aspdigital/AES50/Hardware Design/Schematic.pdf

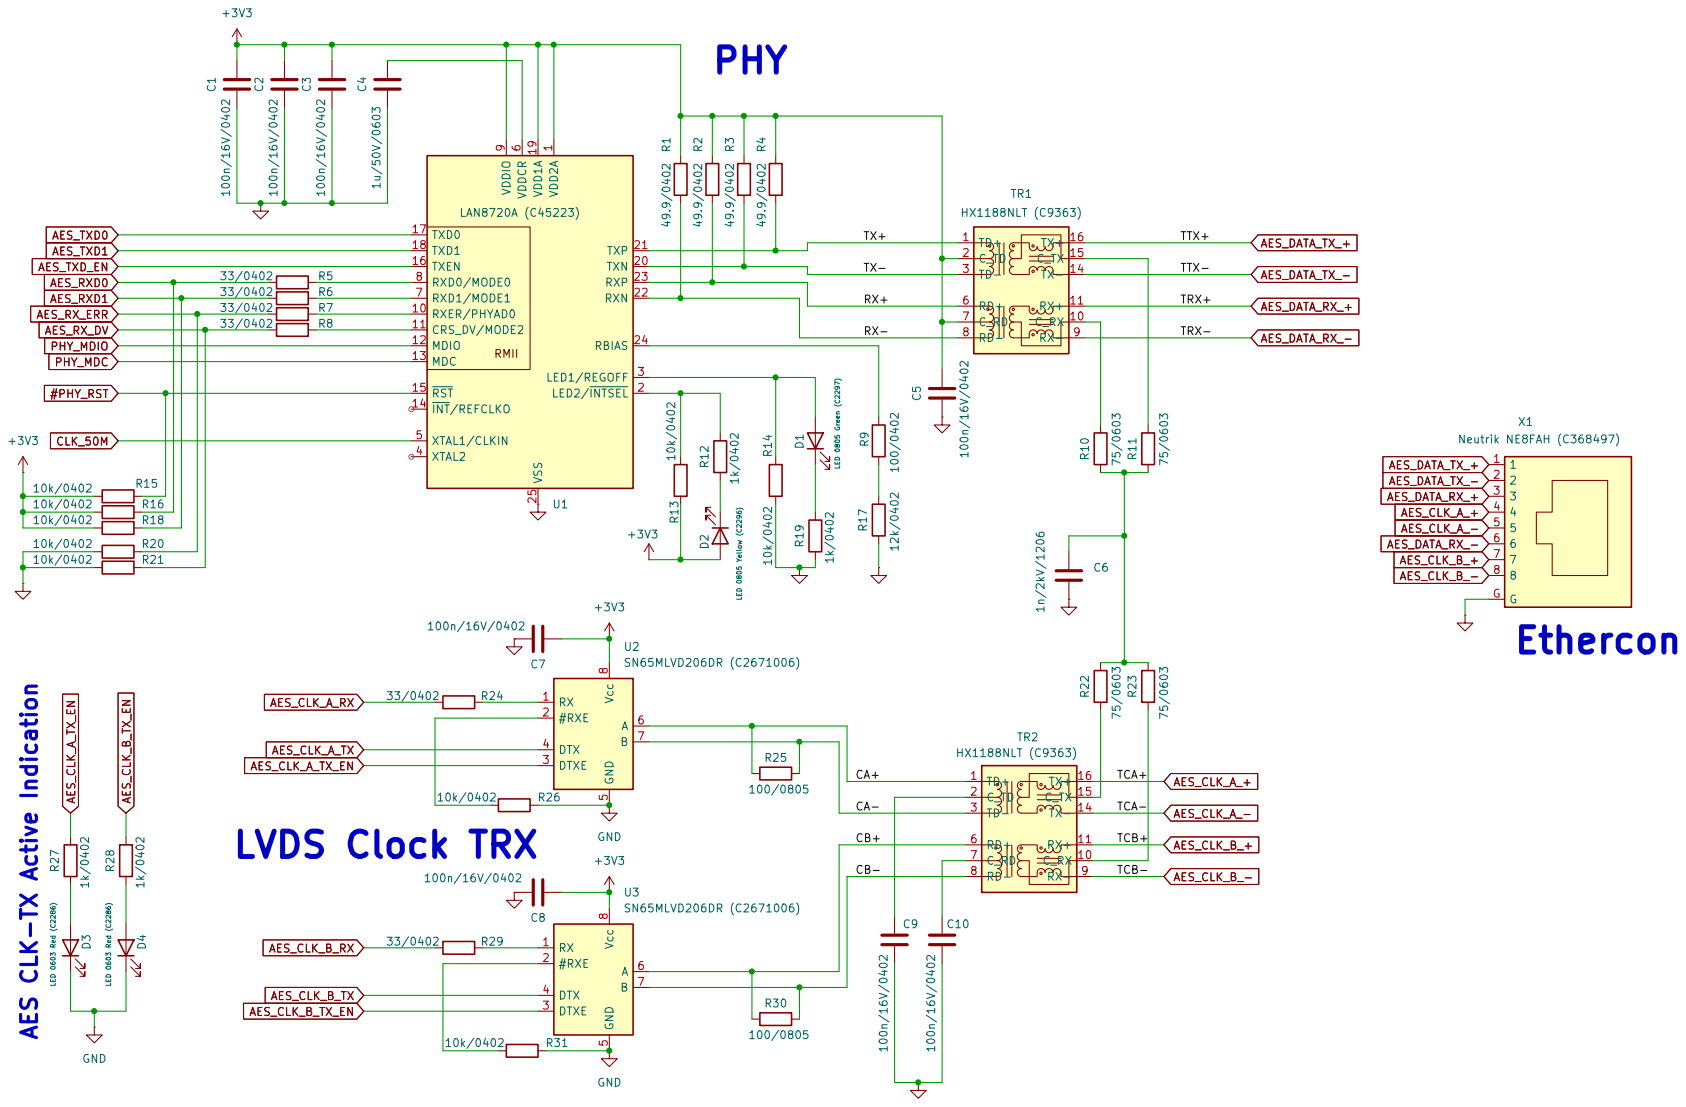
[picture p6: page 2]

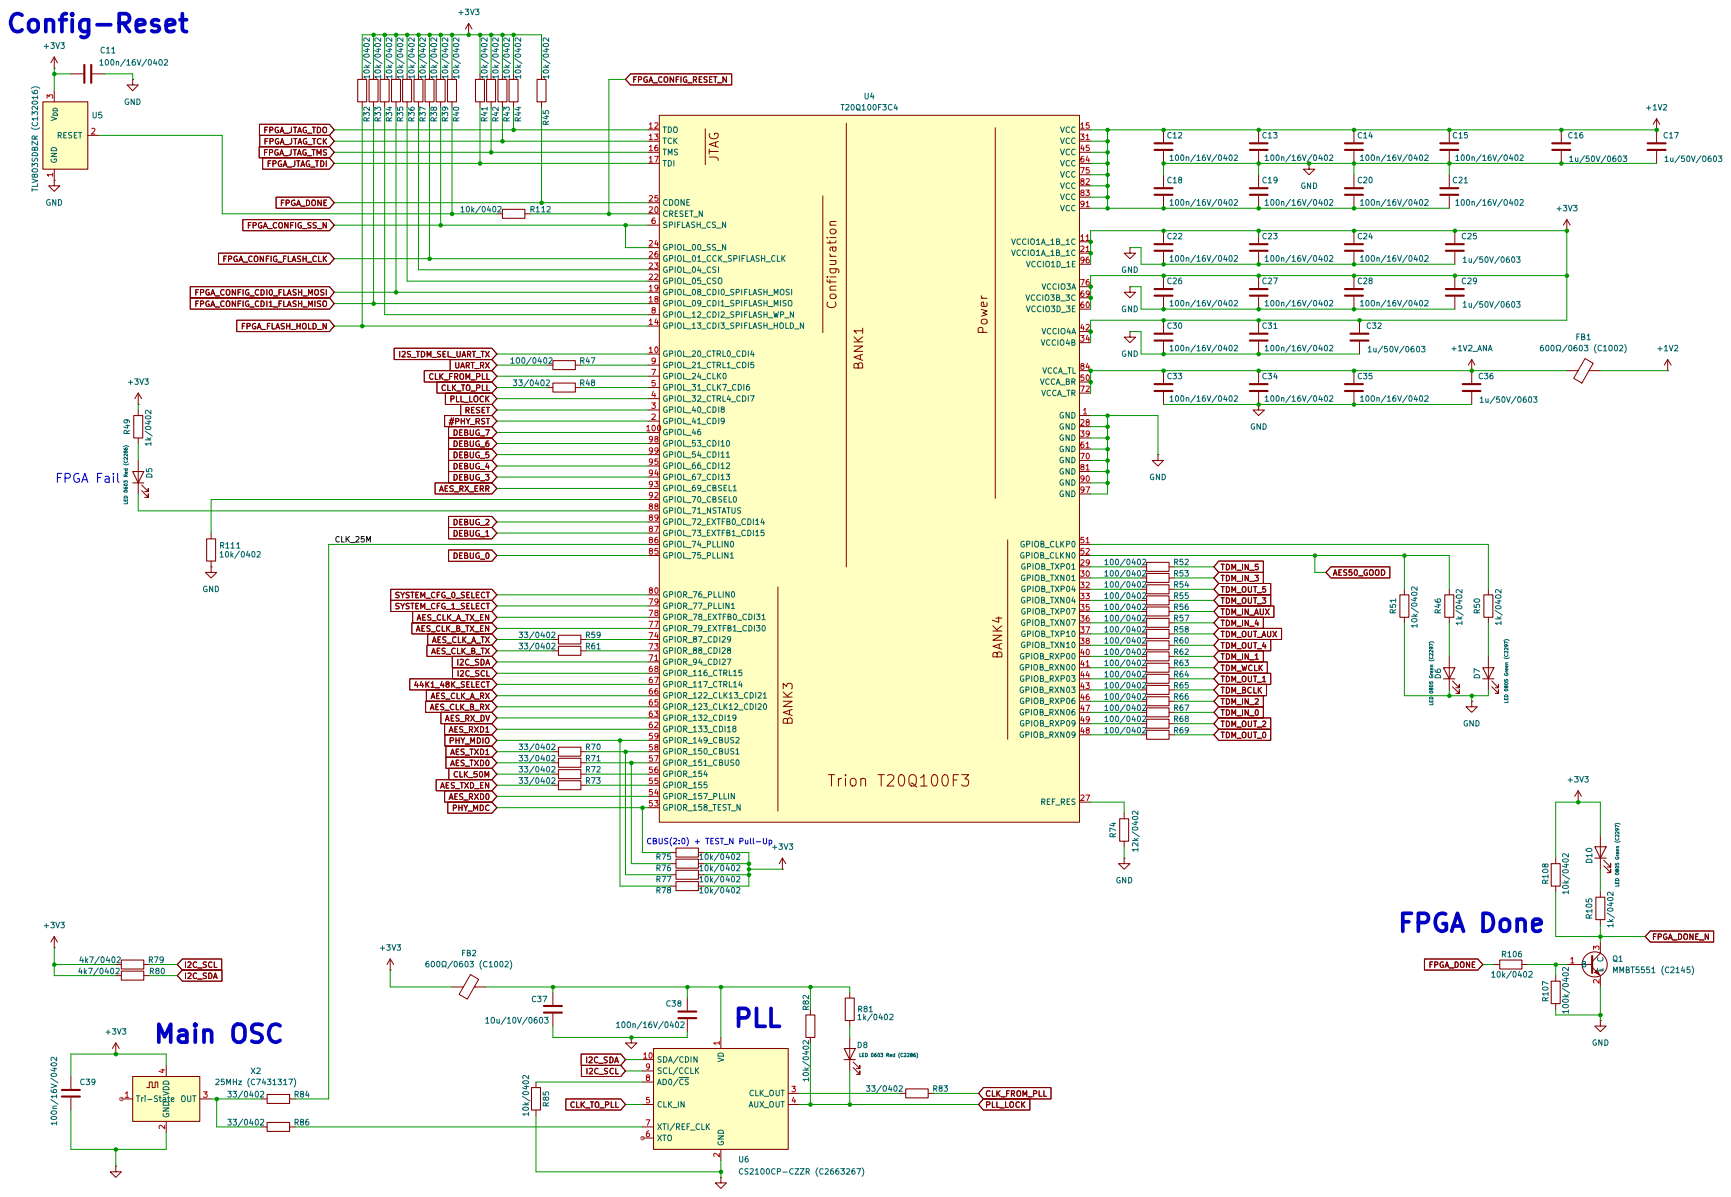
[picture p7: page 3]

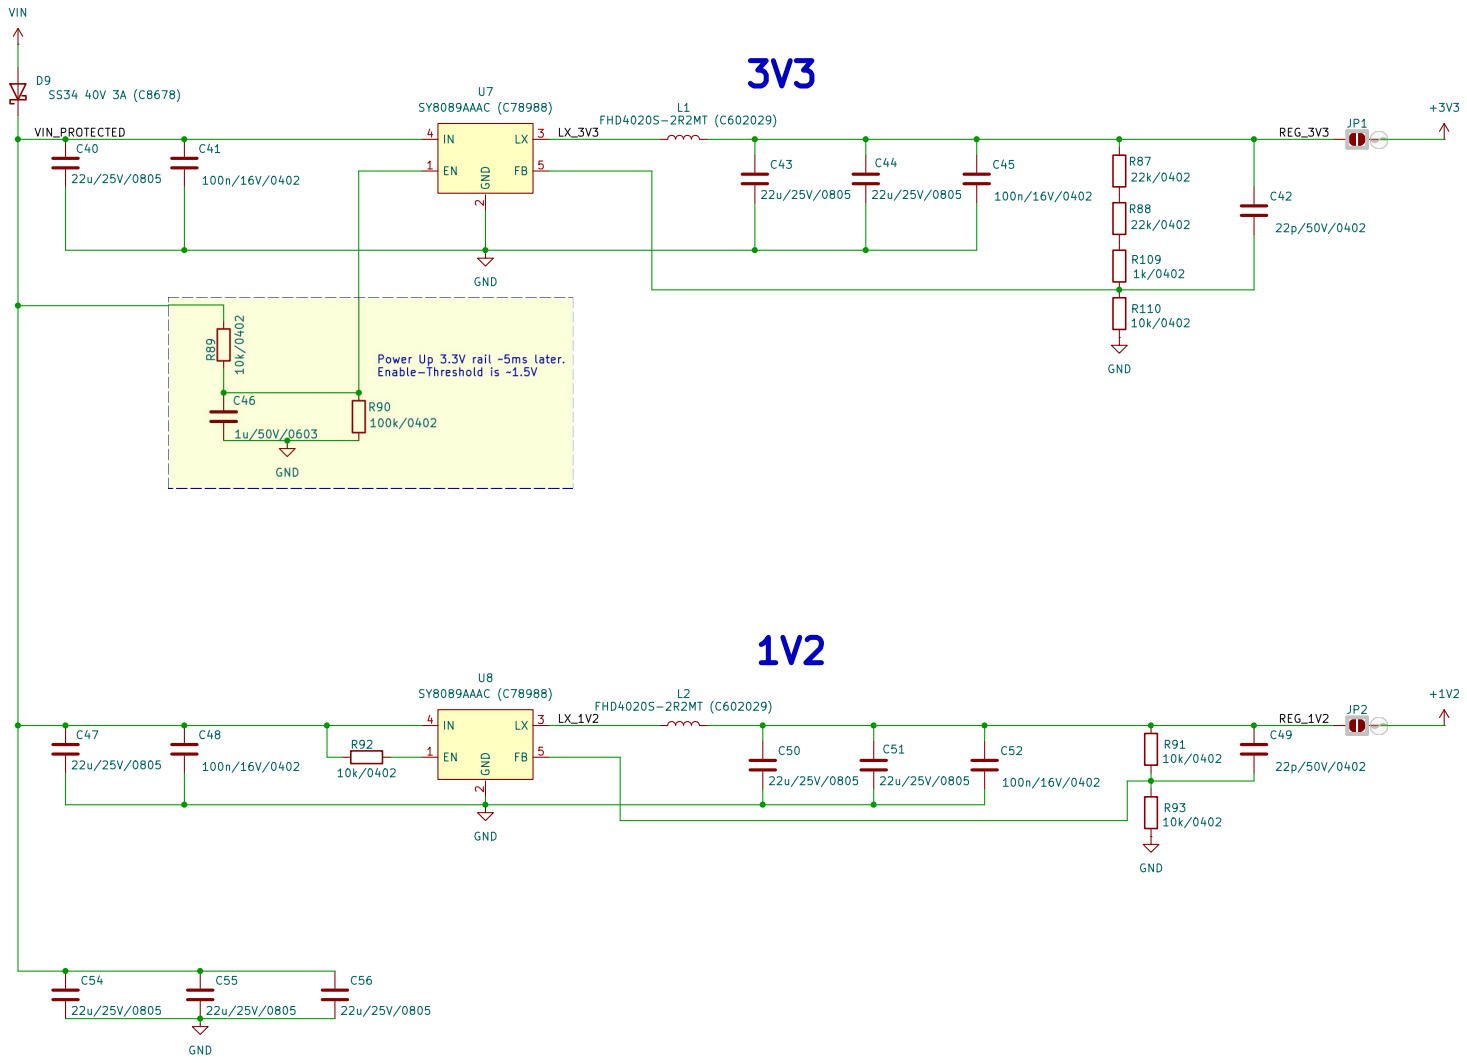
[picture p8: page 4]

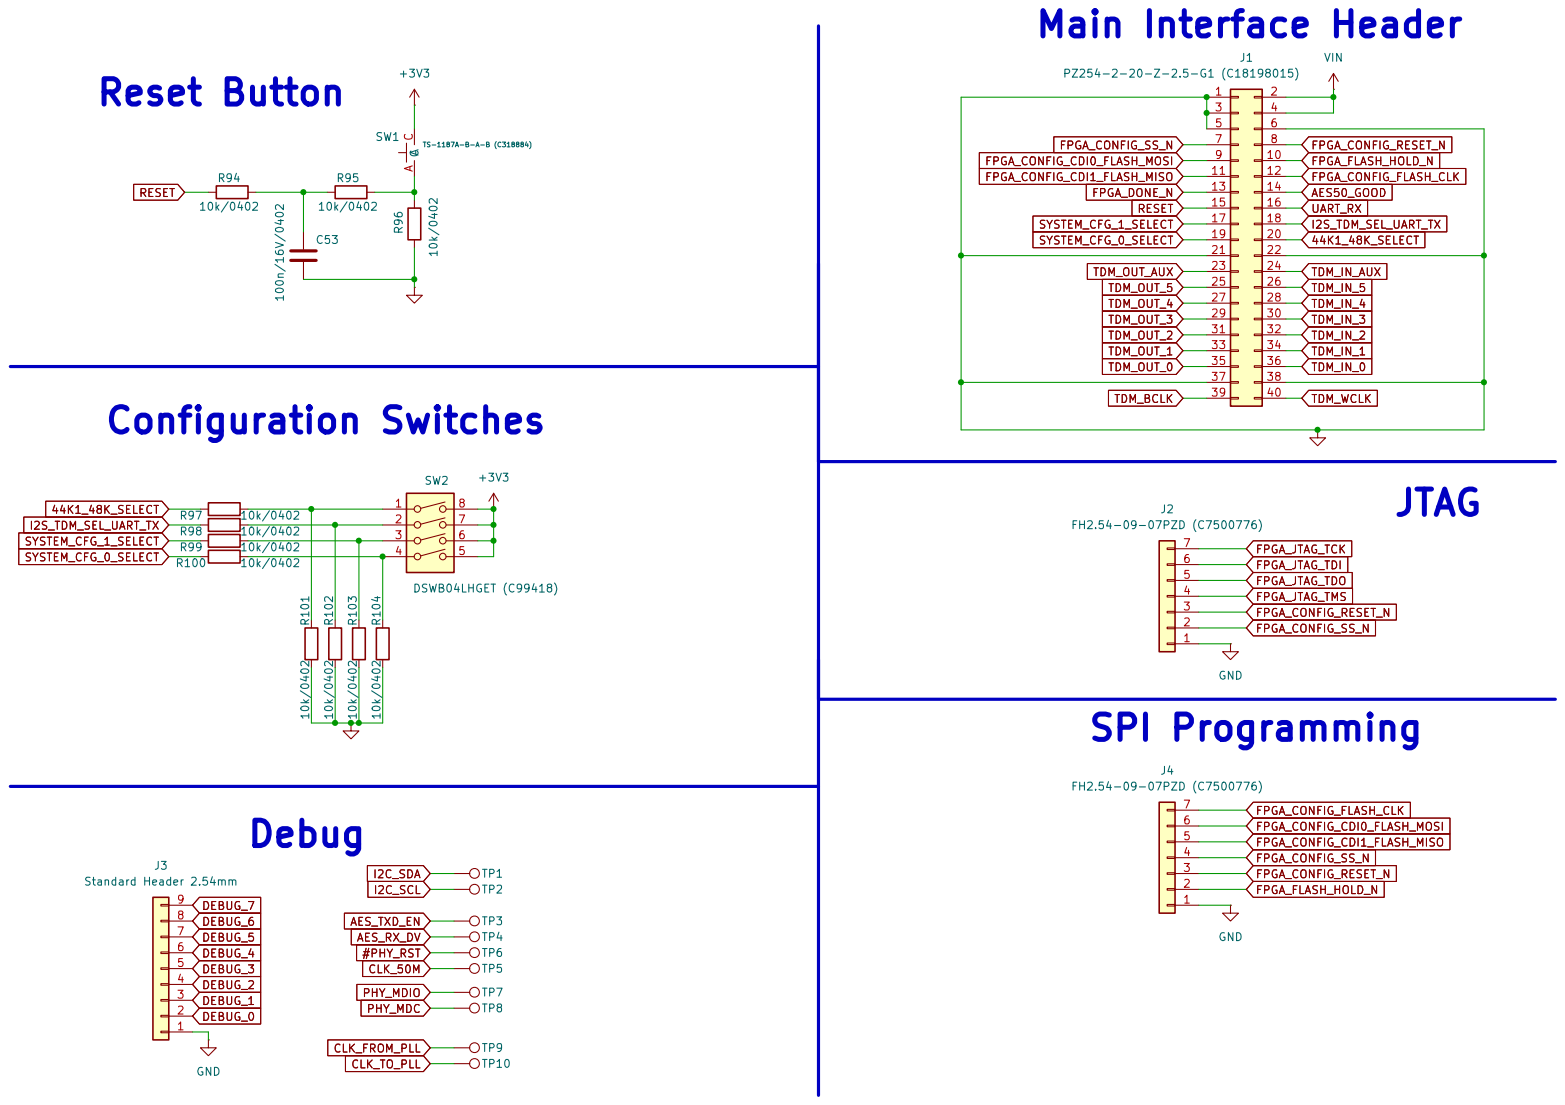
[picture p9: page 5]
