aspdigital/AES50/(commit log)

2026-03-08 renamed uart rx/tx net names in schematic to match actual FPGA implementation. Tidy up things...
2026-03-16 Documentation update about protocol-quirks in original AES50 devices
    Added notes on discrepancies between AES50 specification and commercial implementations, including details on scrambler/descrambler logic and LC-segment structure.
2026-03-27 Major refactor for better synthesis on other FPGA toolchains (if/else statemachine to case-based statemachine; changed integer-datatypes to natural; handling of write/read-enable signals); Fixed dist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
    [aes50_aux_decoder.vhd, aes50_aux_encoder.vhd, aes50_clockmanager.vhd, aes50_cs2x00_pll_controller.vhd, aes50_dual_port_bram.vhd, aes50_ring_buffer.vhd, aes50_rx.vhd, aes50_tdm_if.vhd]
